achalyadav0/RasCube/firmware/README.md

# Firmware

Initial firmware examples for RasCube hardware bring-up. The current examples focus on the SX1278 LoRa radio.
