achalyadav0/RasCube/docs/rascube-flight-stack-wiring.png

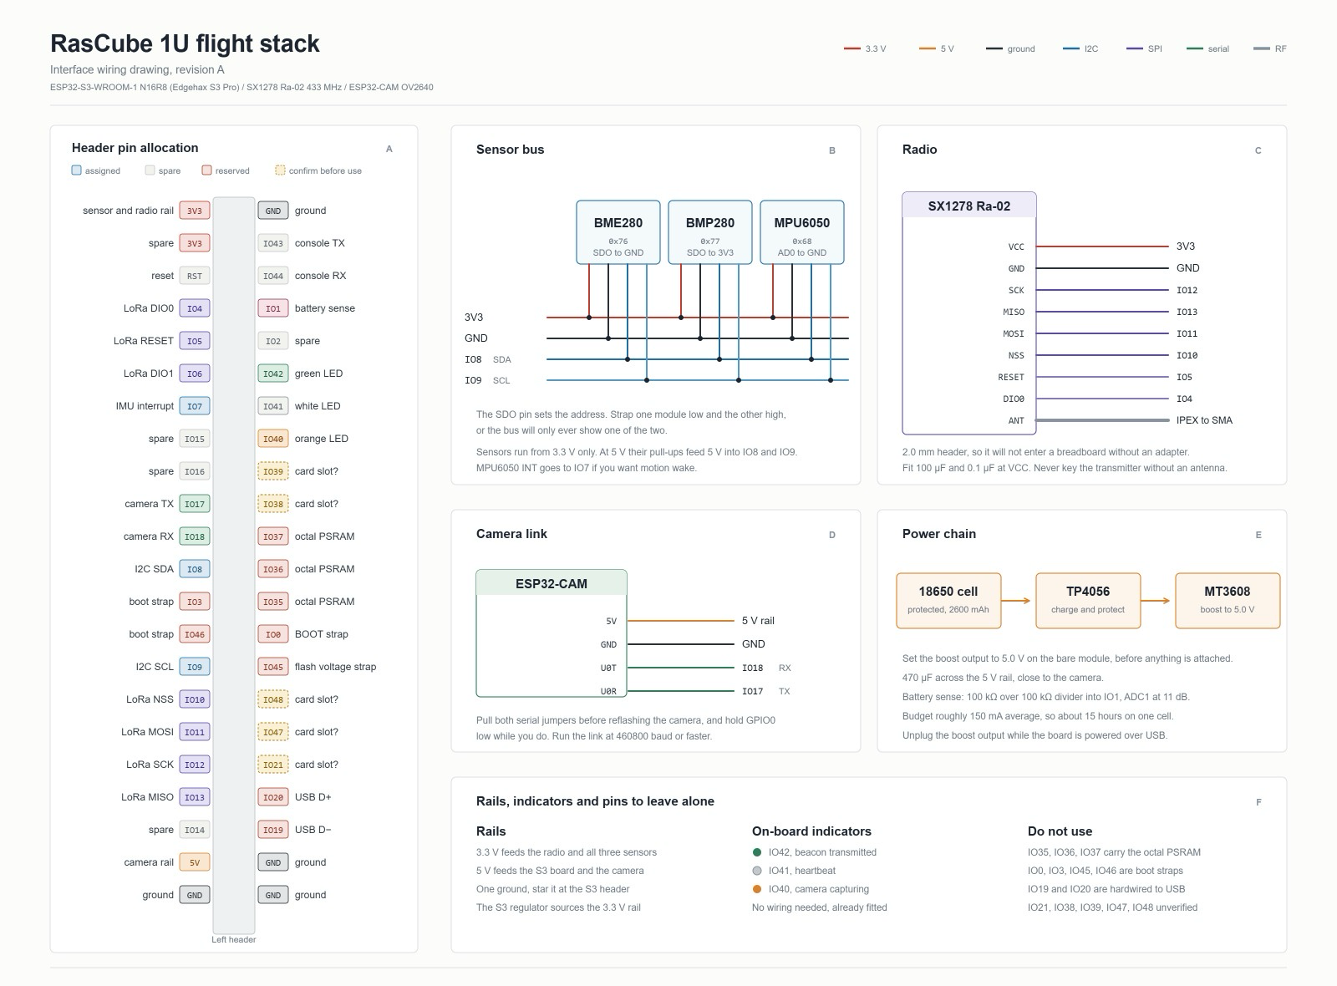
docs/rascube-flight-stack-wiring.png
