achalyadav0/RasCube/images/rascube-build-03.jpeg

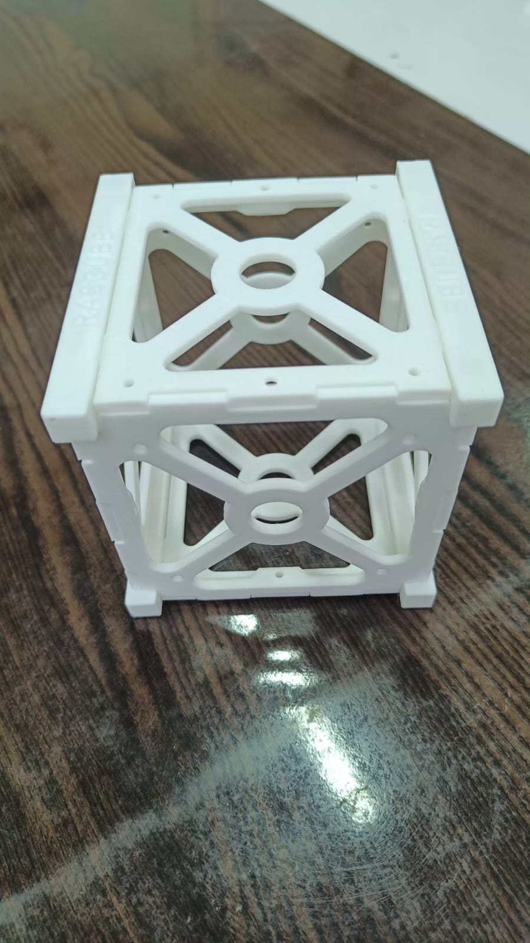
images/rascube-build-03.jpeg
